andykarpov/karabas-128-pcb/README.md

# Karabas-128 PCB

This repo contains a KiCAD sources of the karabas-128 project.

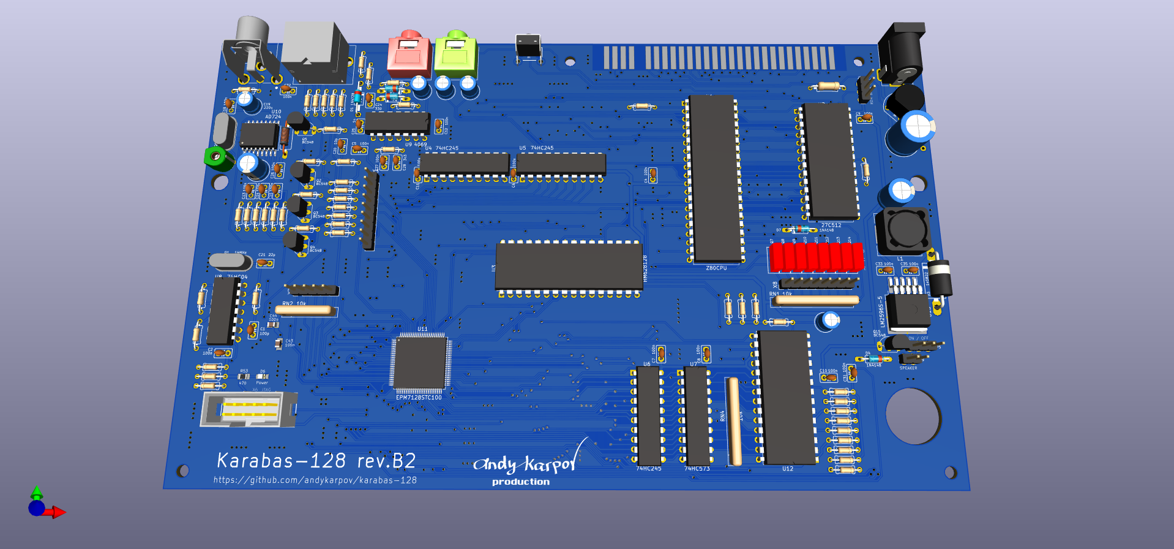
[picture p1: karabas_128_3d.png]
