andykarpov/karabas-128-pcb/karabas_128_revB2_sch.pdf

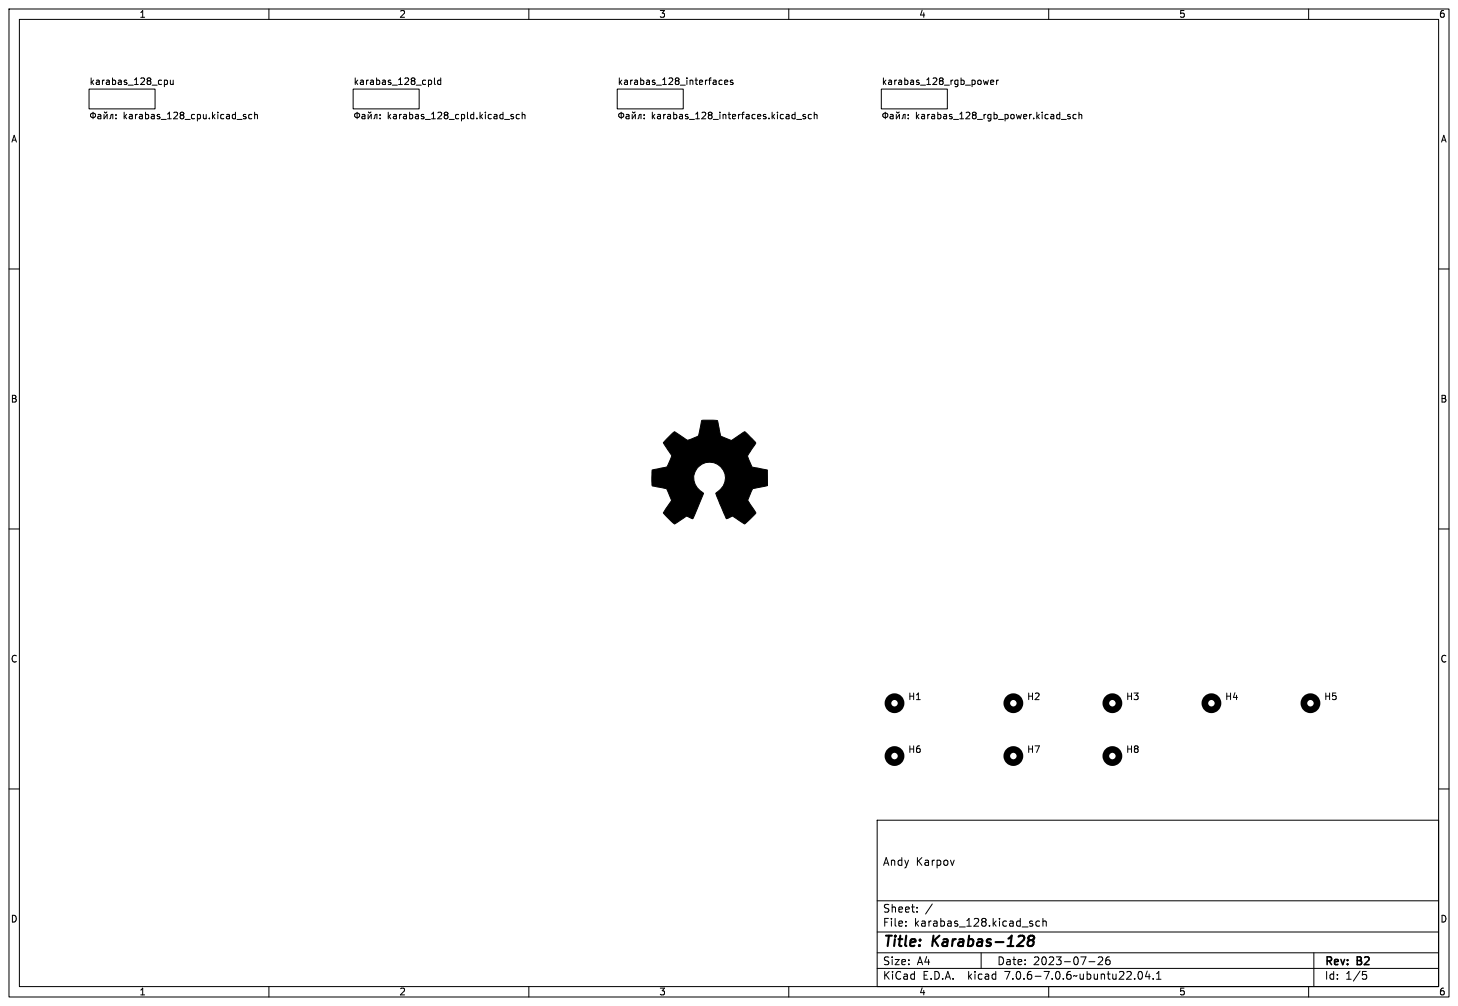
[picture p2: page 1]

File: karabas_128.kicad_sch Sheet: / Andy Karpov

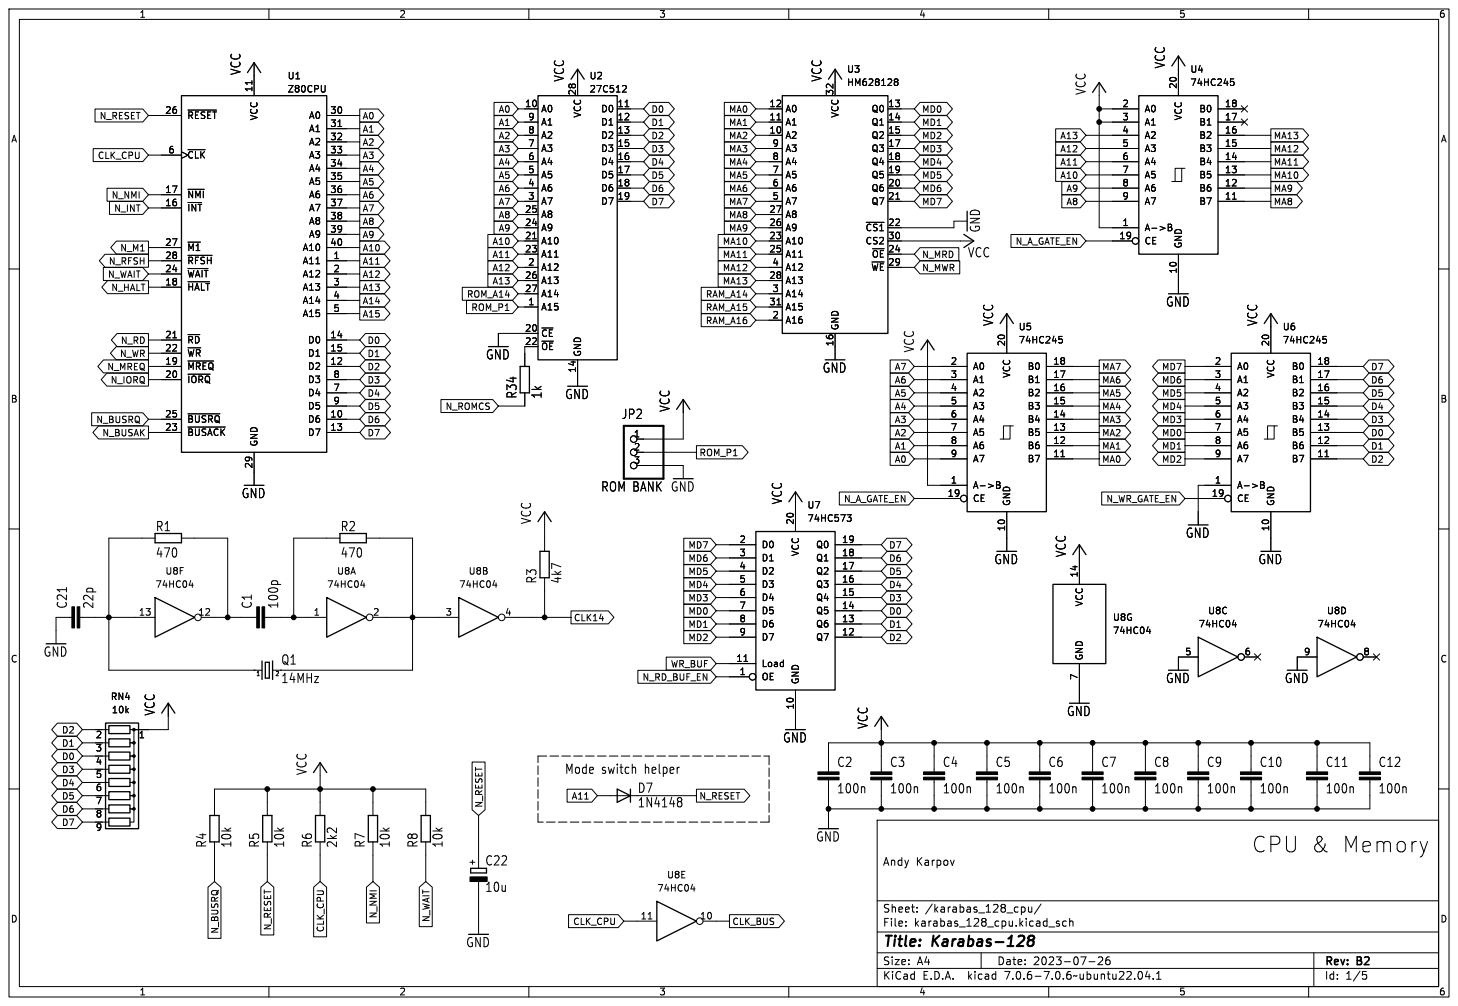
[picture p3: page 2]

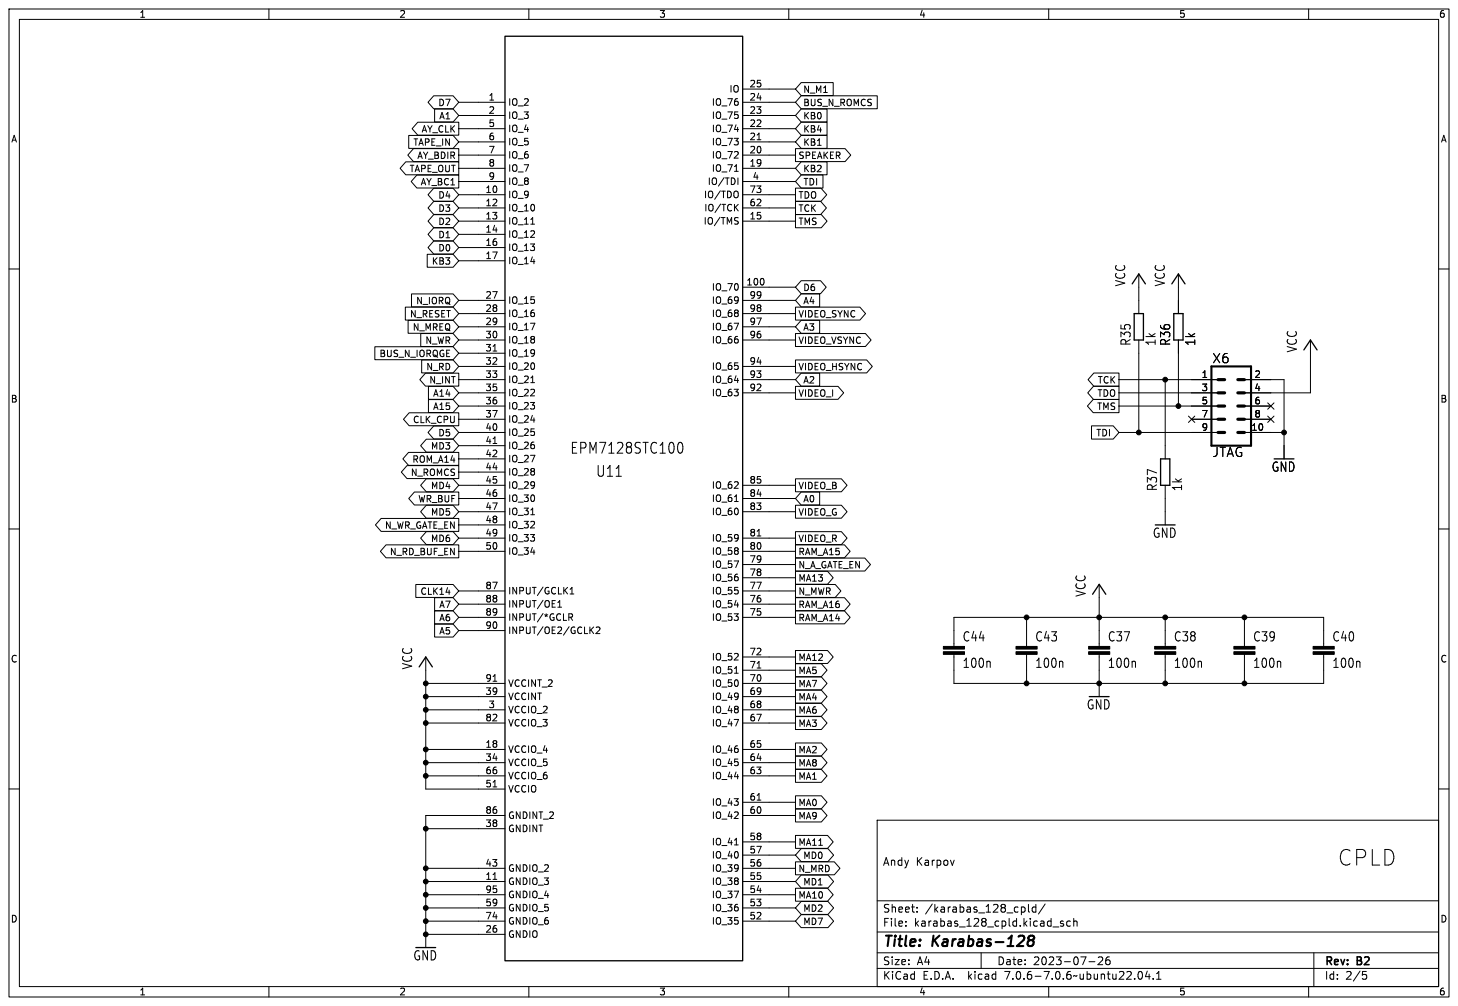
[picture p4: page 3]

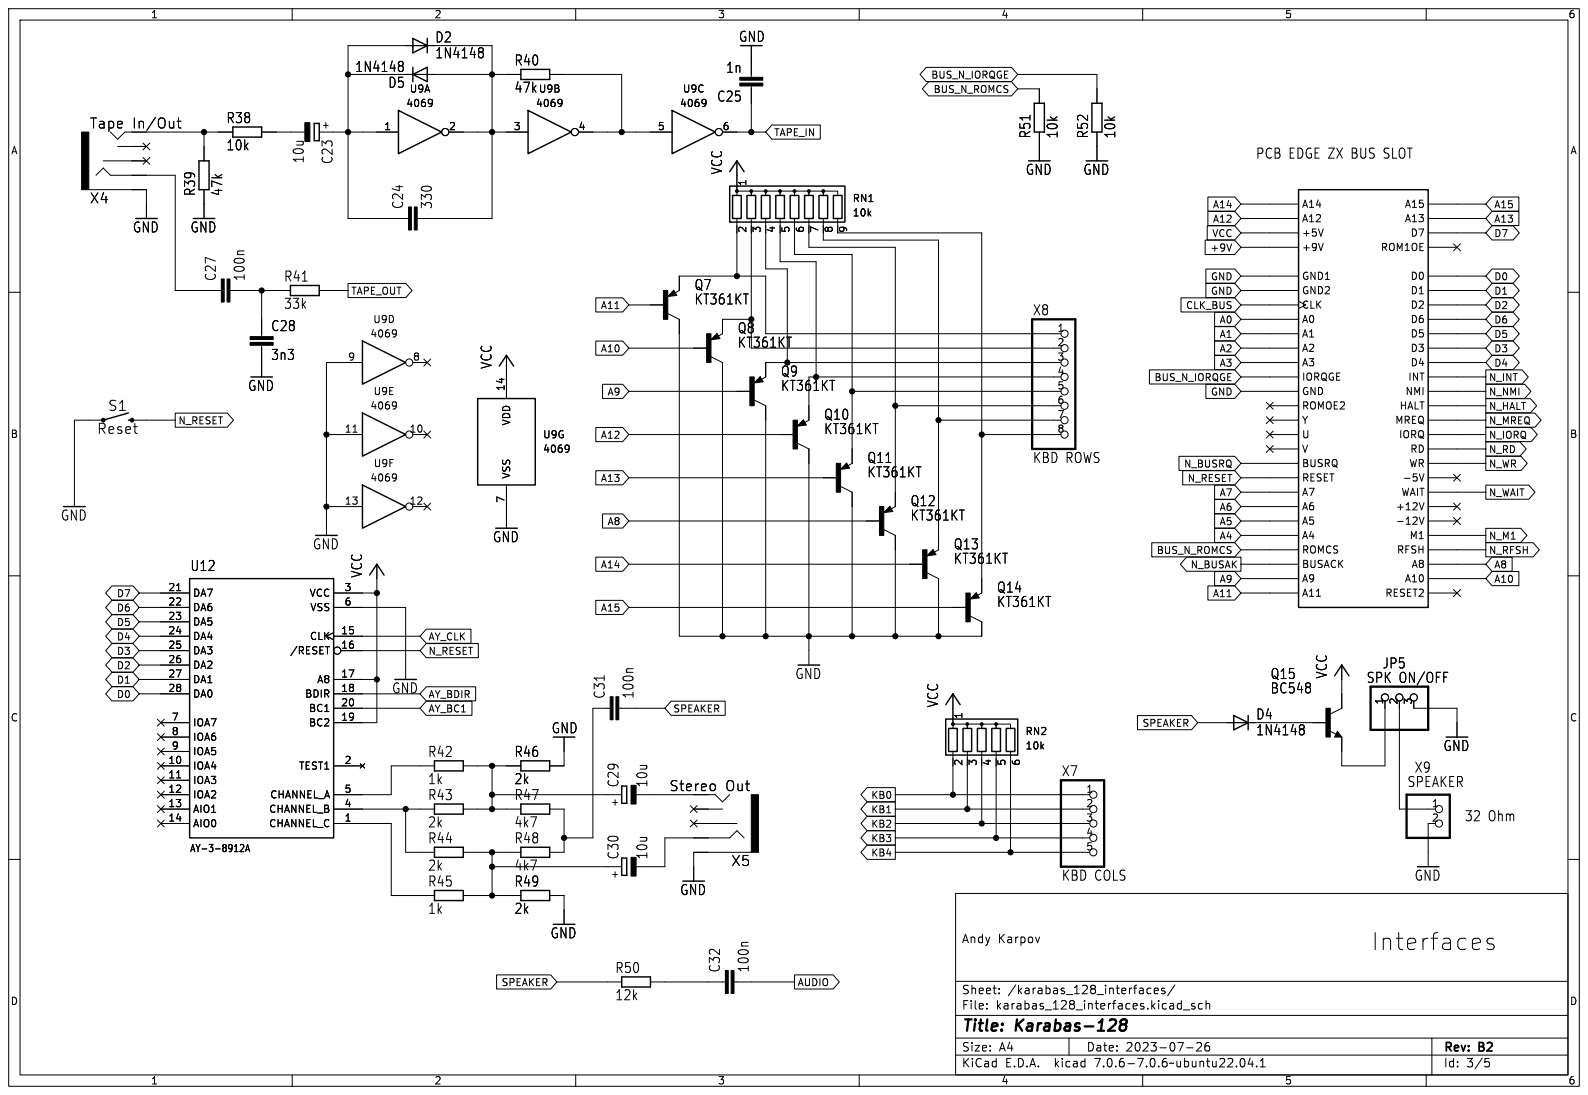
[picture p5: page 4]

PCB EDGE ZX BUS SLOT

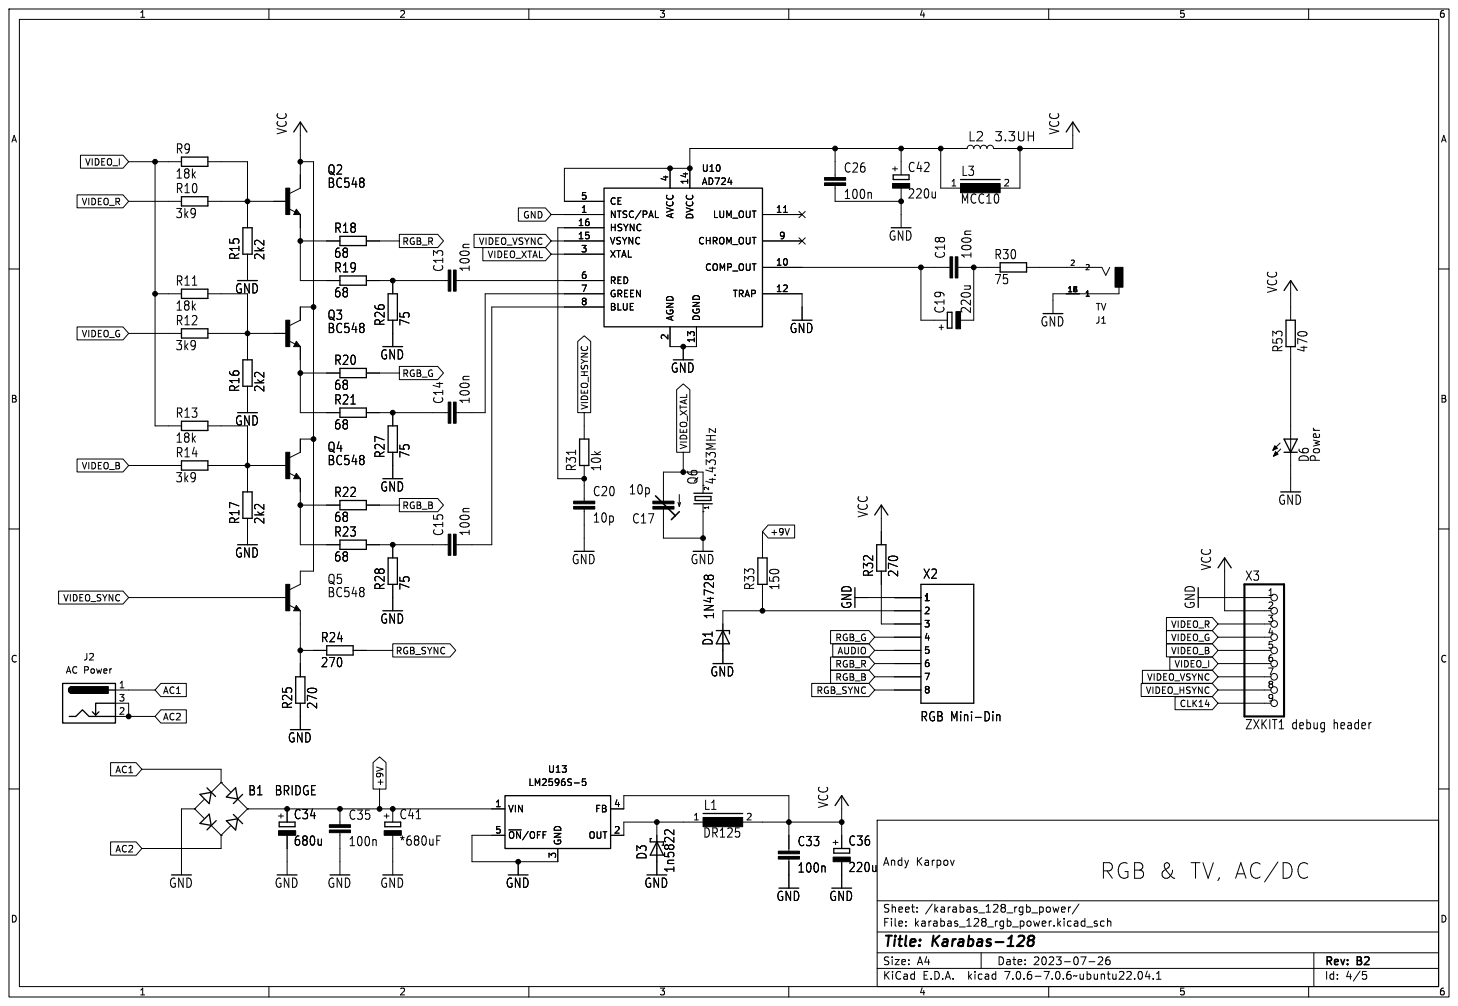
[picture p6: page 5]

4 CE 5 RED 6 GREEN 7 BLUE 8 CHROM_OUT 9 U10 AD724 1 2 L3

4 CE 5 RED 6 GREEN 7 BLUE 8 CHROM_OUT 9 GND

3 FB 4 ~{ON}/OFF 5 GND
