andykarpov/karabas-128-pcb/(commit log)

2023-07-26 Added missing holes
    [karabas_128.kicad_sch]
2023-07-27 Fixed silkscreen
2023-07-27 Replaced power connector symbol and footprint
    [karabas_128_rgb_power.kicad_sch]
2023-07-27 small improvements
    [karabas_128_cpu.kicad_sch, karabas_128_interfaces.kicad_sch, karabas_128_rgb_power.kicad_sch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]
2023-07-28 Kicad symbols (#1)
    * replaced cpu, rom and ram
    * WIP
    * WIP
    * 3d models for the rest components
    * exported gerbers for revB2
    [karabas_128.kicad_sch, karabas_128_cpu.kicad_sch, karabas_128_interfaces.kicad_sch, karabas_128_rgb_power.kicad_sch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]
2023-07-28 updated cap footprint
2023-07-29 updated gerbers
